StefanoT76/Field_Mill/Calibration_procedure/Calibrazione.xlsx

Campo imposto V/m | Campo misurato V/m | Tensione alimentatore V con d = 20cm
-25000 | -24900 | -5000
-15000 | -14000 | -3000
-10000 | -10000 | -2000
-5000 | -4500 | -1000
-1000 | -900 | -200
-500 | -400 | -100
-200 | -202 | -40
-50 | -40 | -10
0 | -30 | 0
50 | 40 | 10
200 | 50.1 | 40
500 | 550 | 100
1000 | 1100 | 200
5000 | 5600 | 1000
10000 | 10400 | 2000
15000 | 15600 | 3000
25000 | 25500 | 5000
m(Valore Misurato)+b = Valore Imposto
Matrice dei coefficienti |  |  | Determinante
50.1 | 1 | 200 | -25449.9
25500 | 1 | 25000
Matrice inversa
-0.000039 | 0.000039
1.001969 | -0.001969
Soluzione |  | Verifica
0.9744635539 | Gain | 200
151.179376 | Offset | 25000
Fattore di scala | 3000
SW Gain | 2923.390662
SW Offset | -151.179376
Campo imposto V/m | Campo misurato V/m | Tensione alimentatore V con d = 20cm
-75000 | -73000 | -15000
-70000 | -69000 | -14000
-60000 | -58000 | -12000
-50000 | -47000 | -10000
-30000 | -29000 | -6000
-20000 | -19000 | -4000
-10000 | -9500 | -2000
-5000 | -5500 | -1000
-1000 | -900 | -200
0 | 50 | 0
1000 | 736 | 200
5000 | 5540 | 1000
10000 | 11317 | 2000
20000 | 22800 | 4000
30000 | 34300 | 6000
50000 | 57300 | 10000
60000 | 68700 | 12000
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
