StefanoT76/Field_Mill/Schematics/SCH_Line_Surge_Protector_2025-07-04.pdf

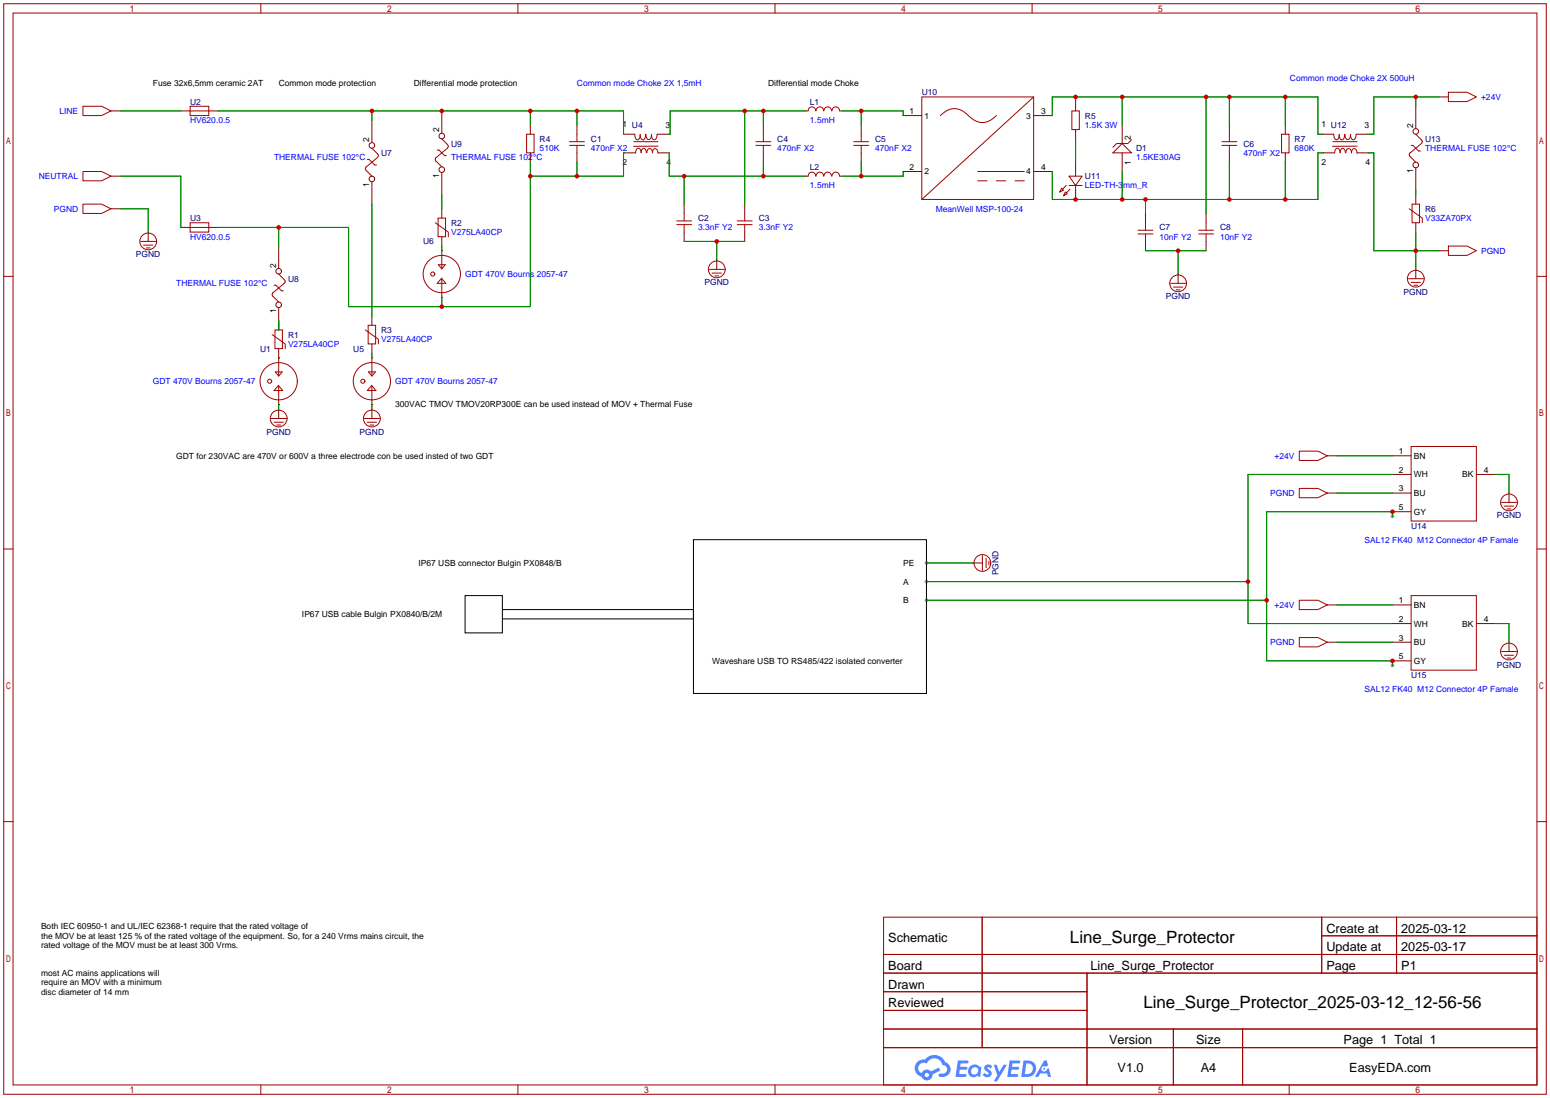
[picture p1: page 1]

300VAC TMOV TMOV20RP300E can be used instead of MOV + Thermal Fuse

GDT for 230VAC are 470V or 600V a three electrode con be used insted of two GDT

Waveshare USB TO RS485/422 isolated converter

Both IEC 60950-1 and UL/IEC 62368-1 require that the rated voltage of
the MOV be at least 125 % of the rated voltage of the equipment. So, for a 240 Vrms mains circuit, the
rated voltage of the MOV must be at least 300 Vrms.

Schematic | Line_Surge_Protector | Create at | 2025-03-12

Update at | 2025-03-17

Board | Line_Surge_Protector | Page | P1
Drawn | | Line_Surge_Protector_2025-03-12_12-56-56
Reviewed

most AC mains applications will
require an MOV with a minimum
disc diameter of 14 mm

Version | Size | Page 1 Total 1
V1.0 | A4 | EasyEDA.com
