StefanoT76/Field_Mill/Schematics/Schematic_Field_Mill_Analog_BD_2025-07-04.pdf

# Insensitive channel

# Sensitive channel

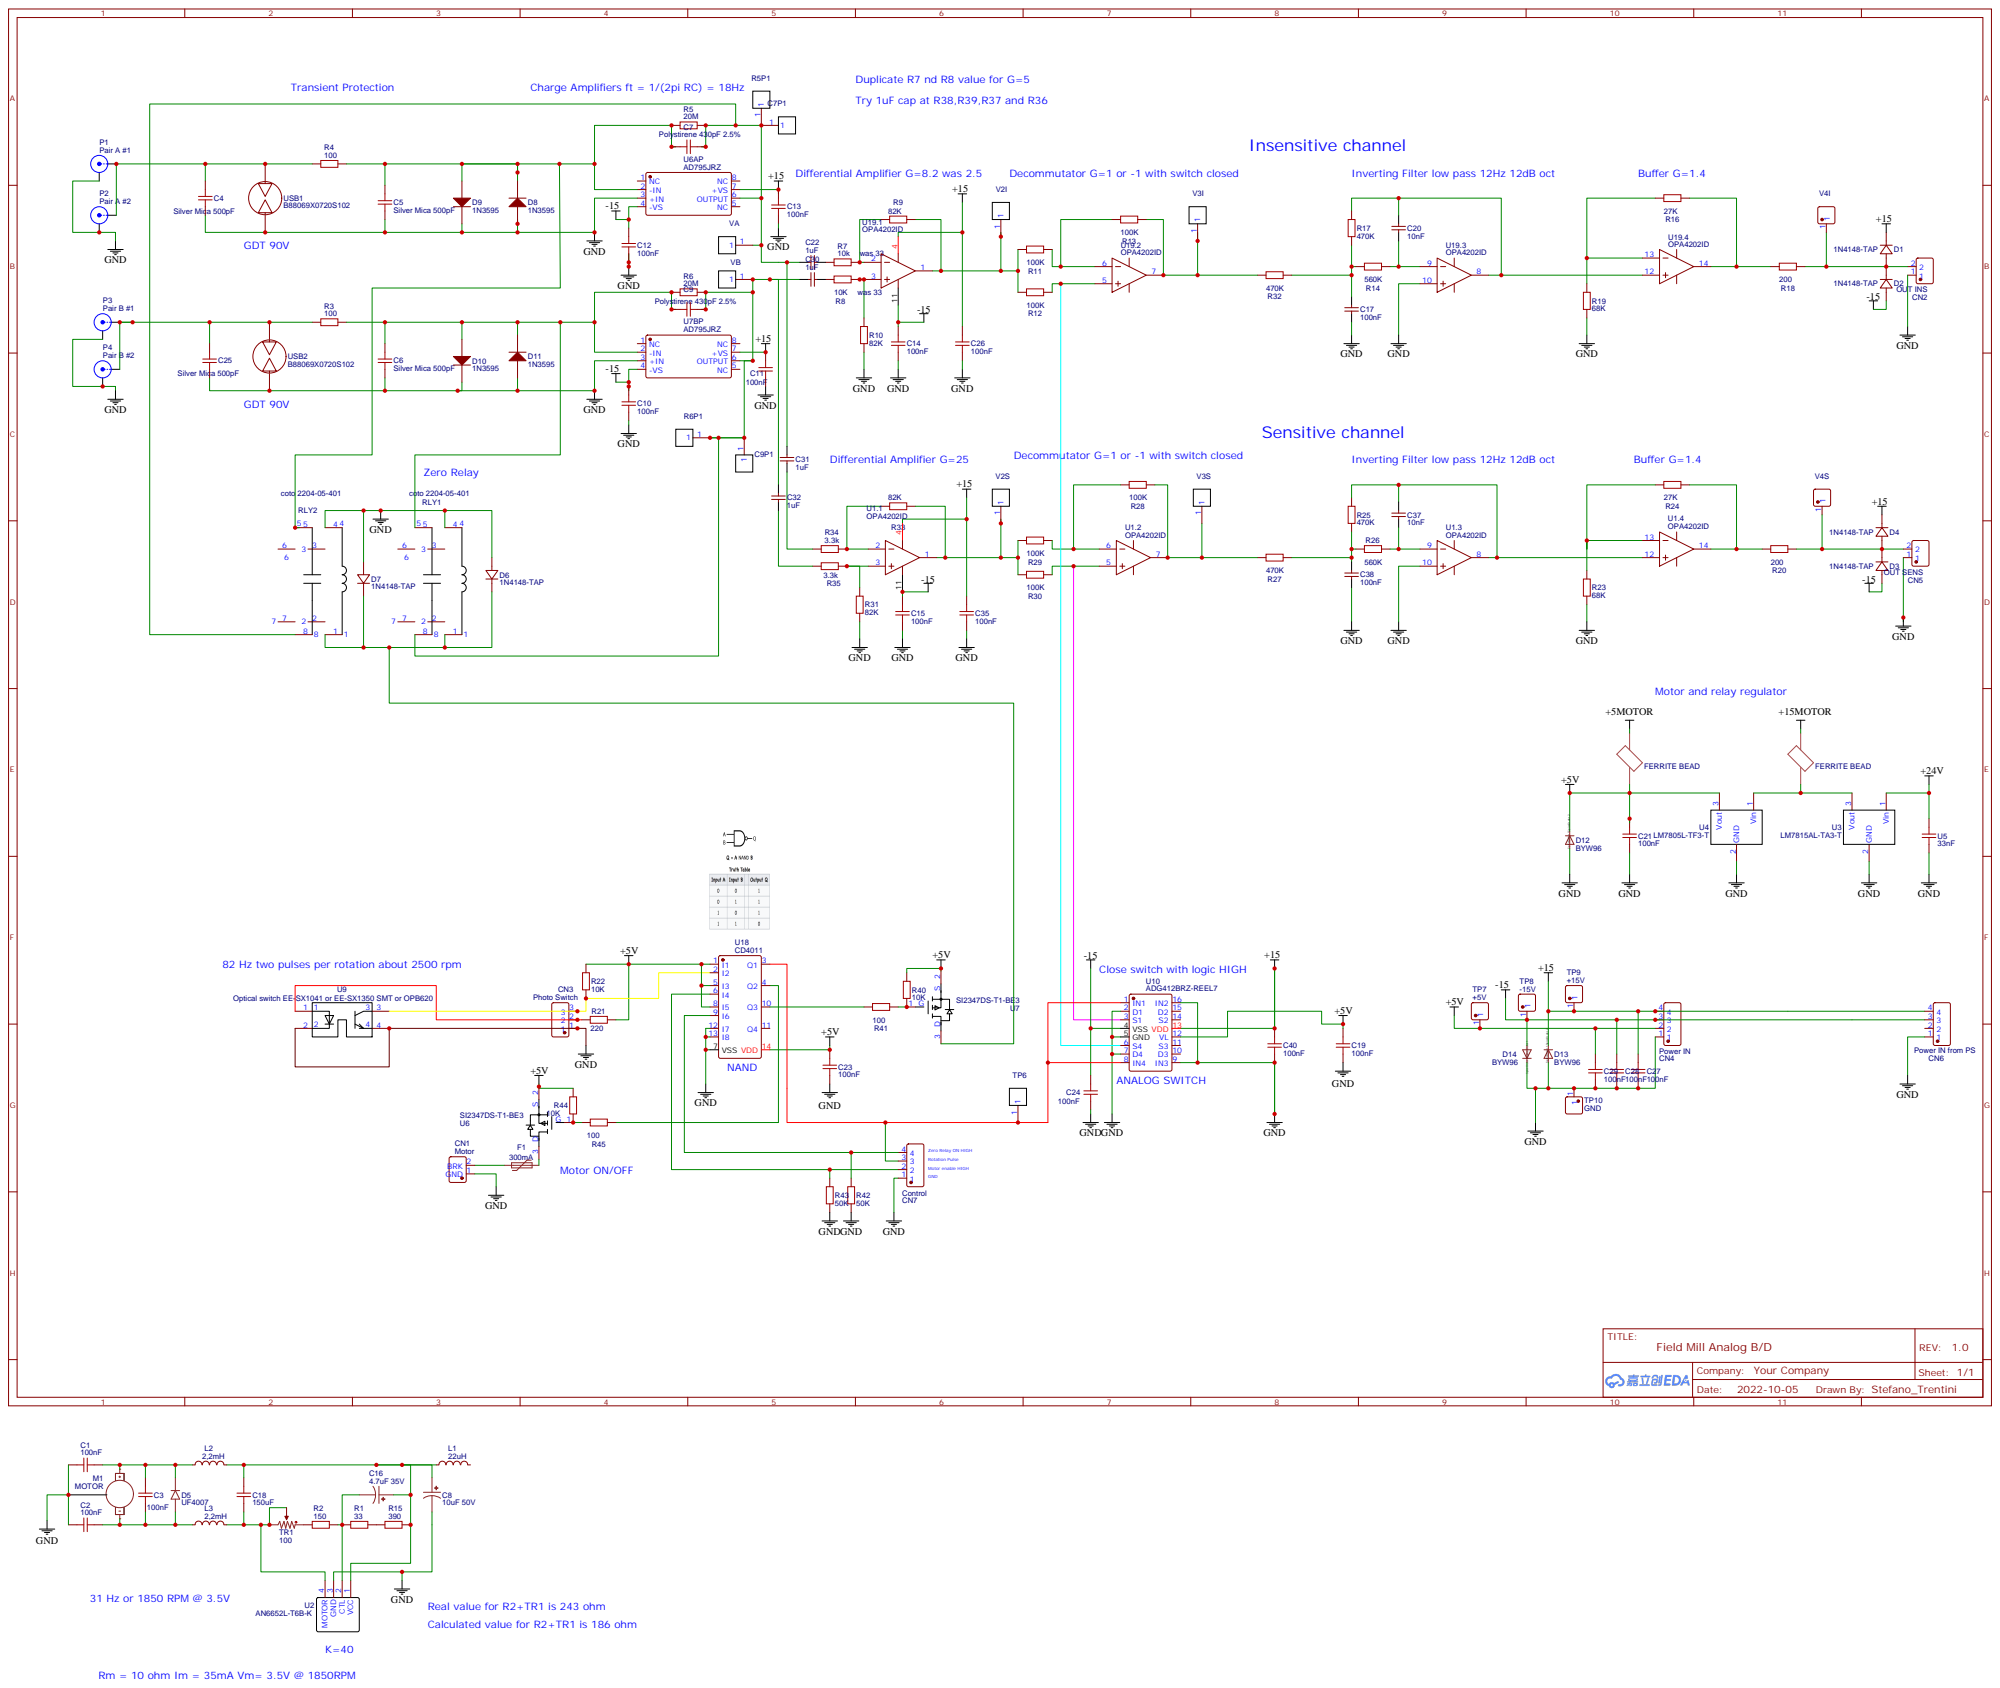
[picture p2: page 1]

Duplicate R7 nd R8 value for G=5
Try 1uF cap at R38,R39,R37 and R36

Charge Amplifiers ft = 1/(2pi RC) = 18Hz

Decommutator G=1 or -1 with switch closed

Motor and relay regulator

Close switch with logic HIGH

82 Hz two pulses per rotation about 2500 rpm

Optical switch EE-SX1041 or EE-SX1350 SMT or OPB620

Zero Relay ON HIGH
Rotation Pulse
Motor enable HIGH
GND

Real value for R2+TR1 is 243 ohm
Calculated value for R2+TR1 is 186 ohm

Rm = 10 ohm Im = 35mA Vm= 3.5V @ 1850RPM
