StefanoT76/Field_Mill/Schematics/Schematic_Field_Mill_Logic_BD-PS_2025-07-04.pdf

## Input protection OC, OV, Reverse polarity, EMI, Transient +24V

## POWER SUPPLY

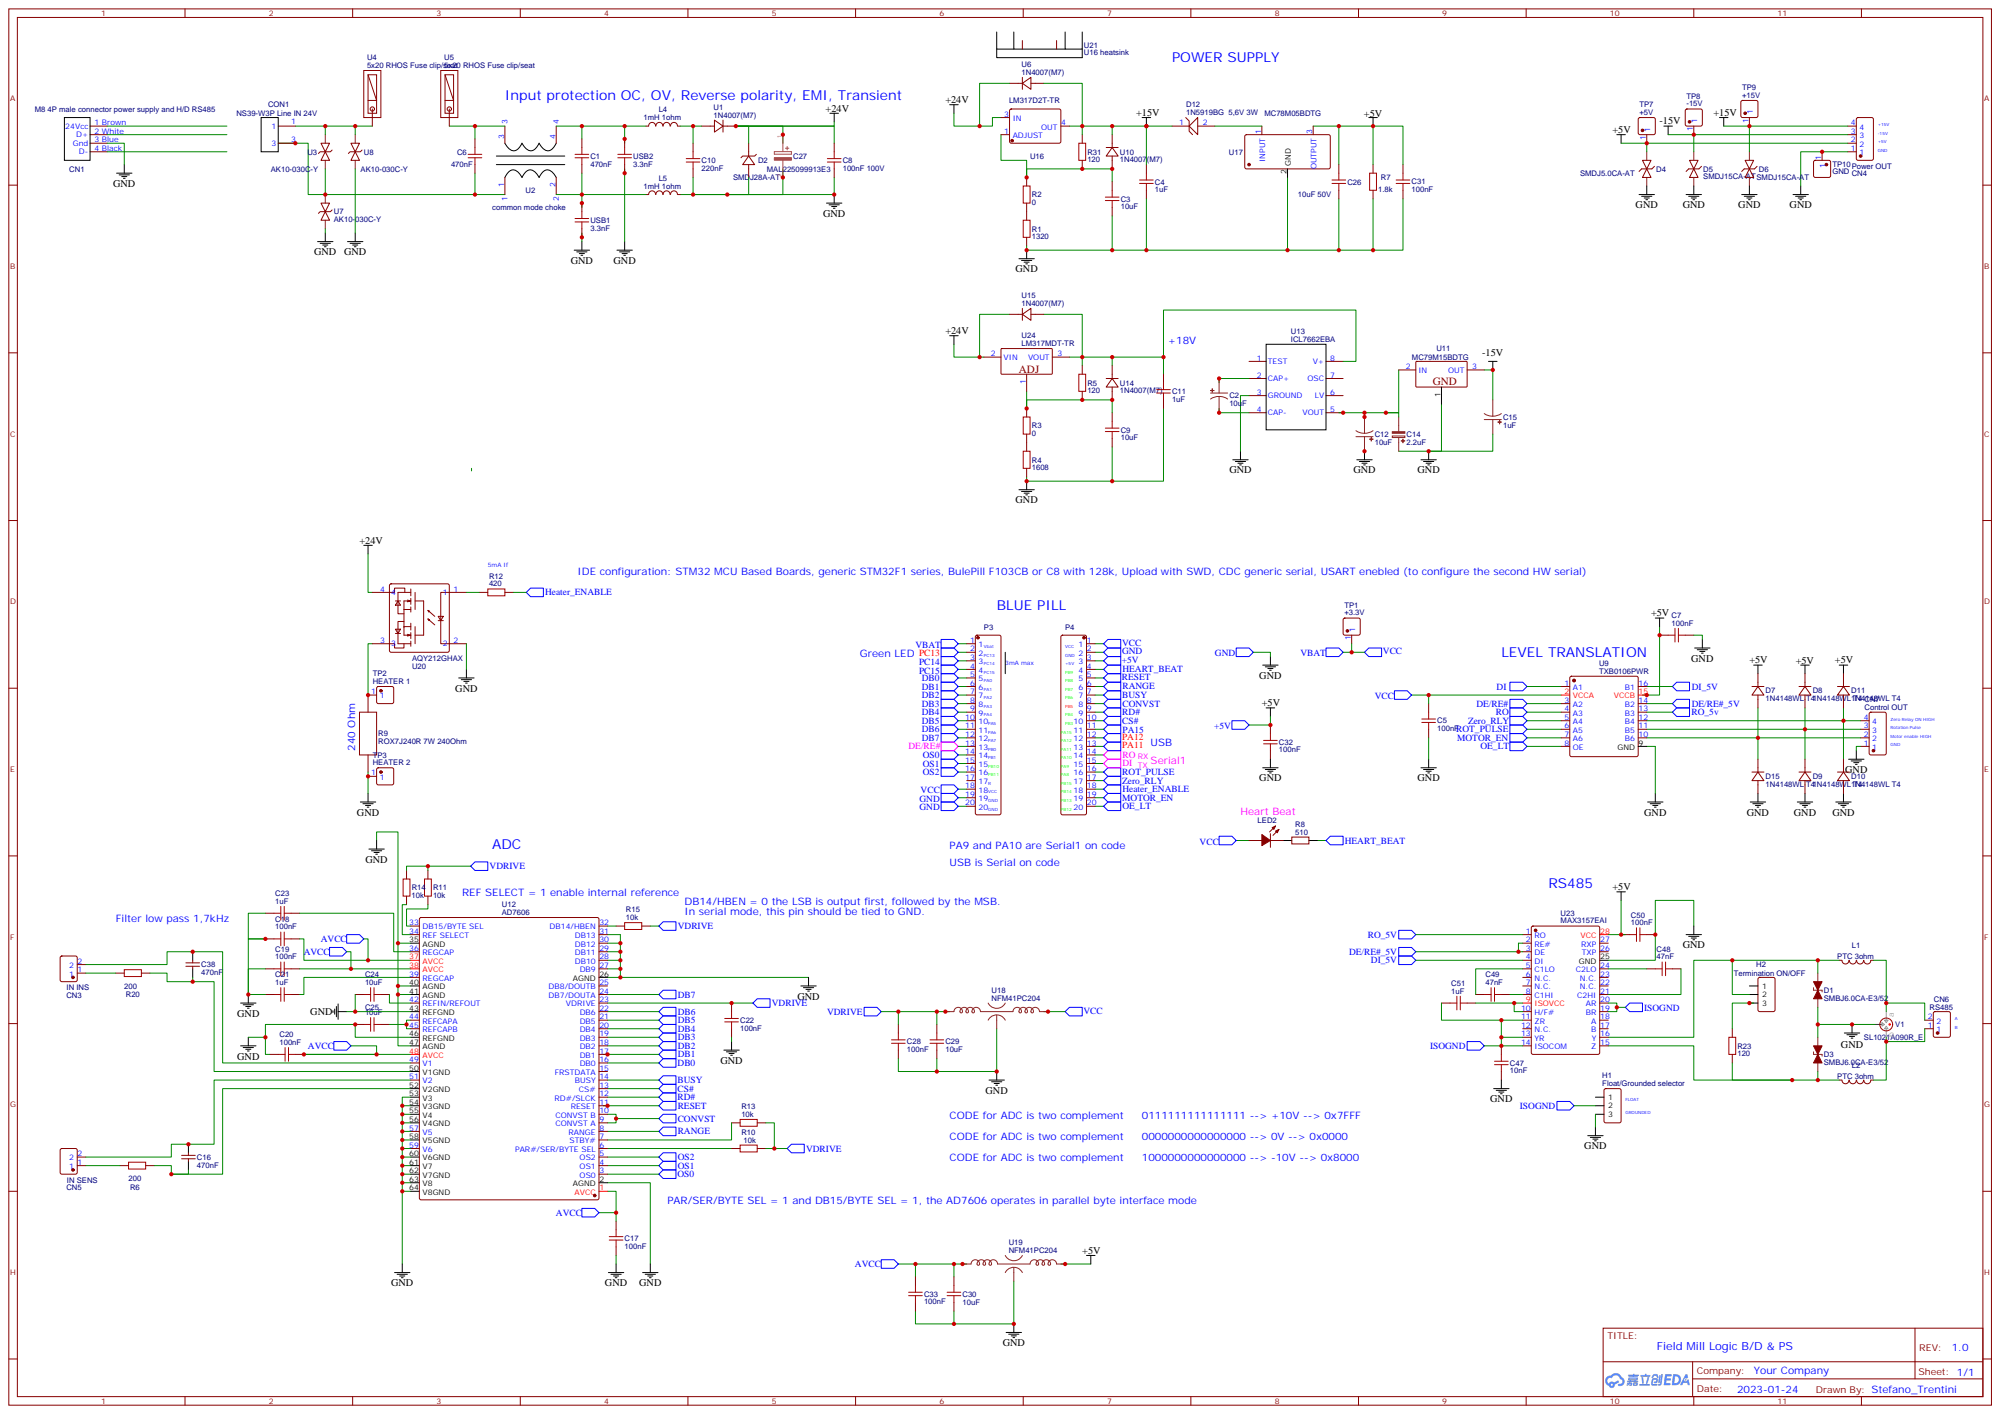
[picture p3: page 1]

5x20 RHOS Fuse clip/seat

M8 4P male connector power supply and H/D RS485

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

Zero Relay ON HIGH
Rotation Pulse
Motor enable HIGH
GND

PA9 and PA10 are Serial1 on code
USB is Serial on code

DB14/HBEN = 0 the LSB is output first, followed by the MSB.
In serial mode, this pin should be tied to GND.
VDRIVE

PAR#/SER/BYTE SEL 6

PAR/SER/BYTE SEL = 1 and DB15/BYTE SEL = 1, the AD7606 operates in parallel byte interface mode
