StefanoT76/Field_Mill/Schematics/Schematic_Field_Mill_Motor_Control_2025-07-04.pdf

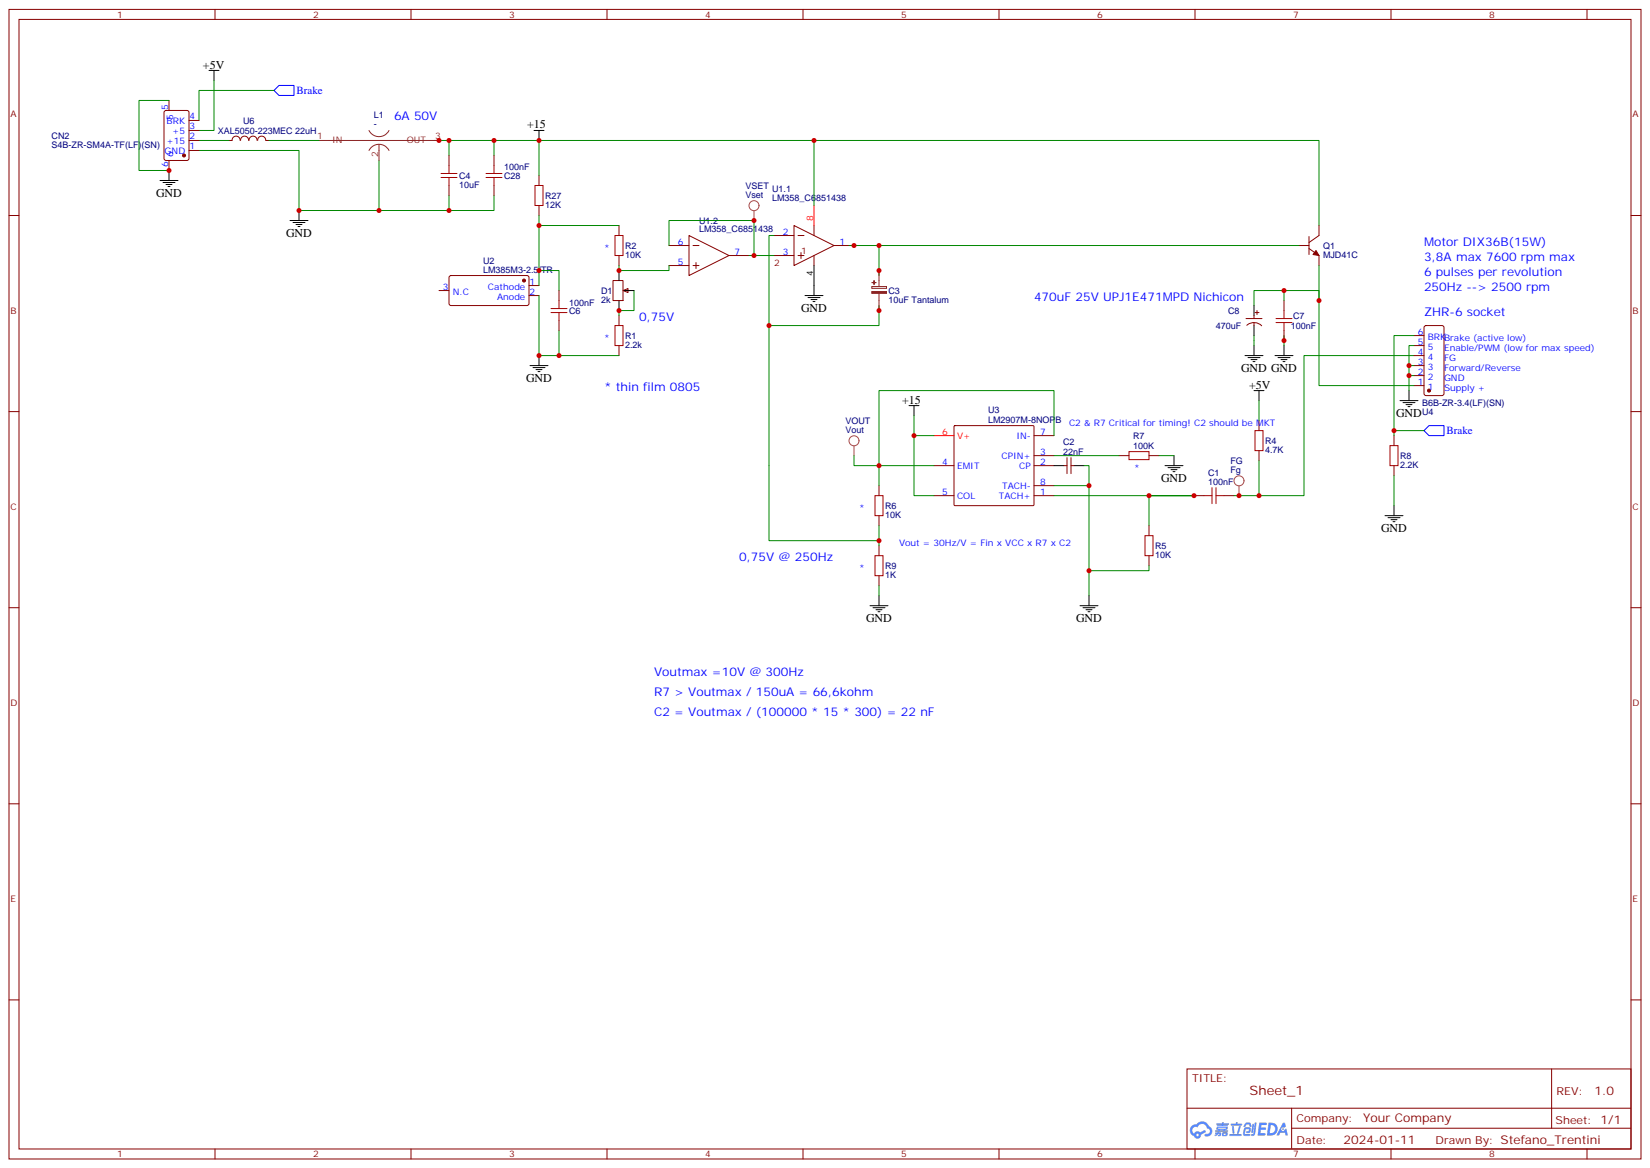
[picture p4: page 1]
