StefanoT76/Field_Mill/(commit log)

2025-06-03 Aggiungere i file di progetto.
2025-06-04 Update and rename LICENSE.md to Calibration
2025-06-06 Smaller font for buttons
2025-06-26 Added exception handling for read buttons and toggle for plate short button
2025-06-27 Added finction buttons and calibration to readings and log
2025-06-30 Added write eeprom button and overflow colors
2025-07-03 Added log and calibration stored in document folder
